wakuwakumiwaku/QC20/Part11.stl

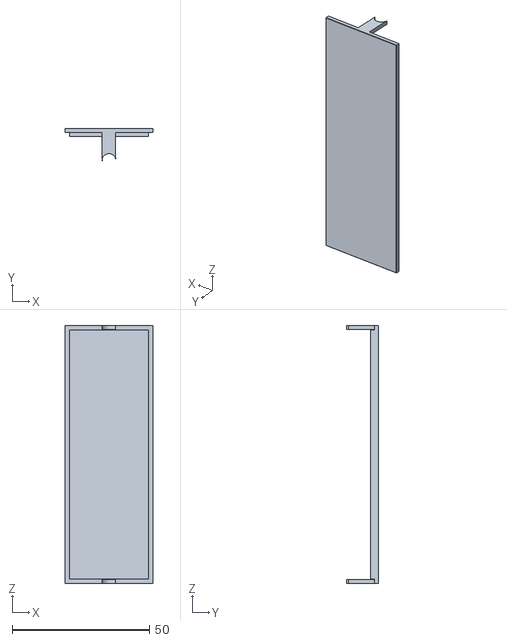
[picture p9: CAD file, 2025-02-26]
Part11.stl
32.0 x 11.8 x 94.0
