wakuwakumiwaku/QC20/Part22.stl

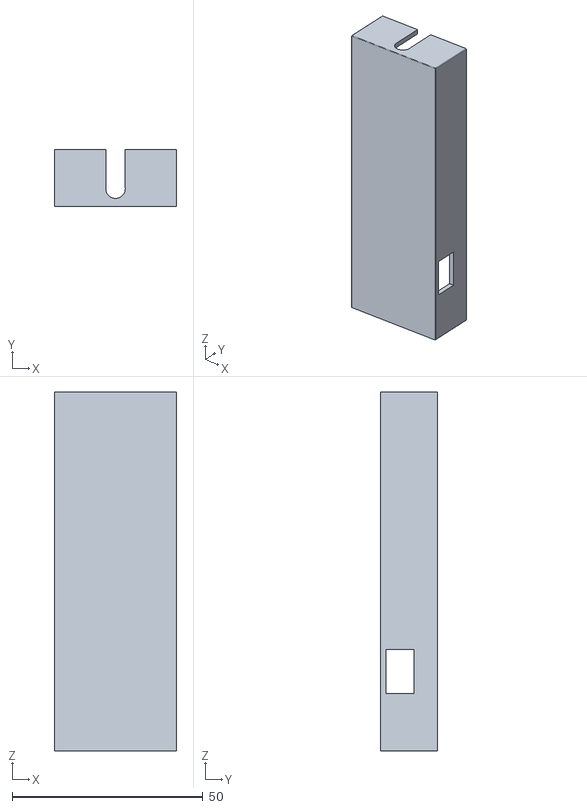
[picture p10: CAD file, 2025-02-26]
Part22.stl
32.0 x 15.0 x 94.0
